kelly-kassin/PROJET_COMMUNICATION_CHIFFREE/Partie_ARCHITECTURE/Capture d'écran 2026-10-26 230341.png

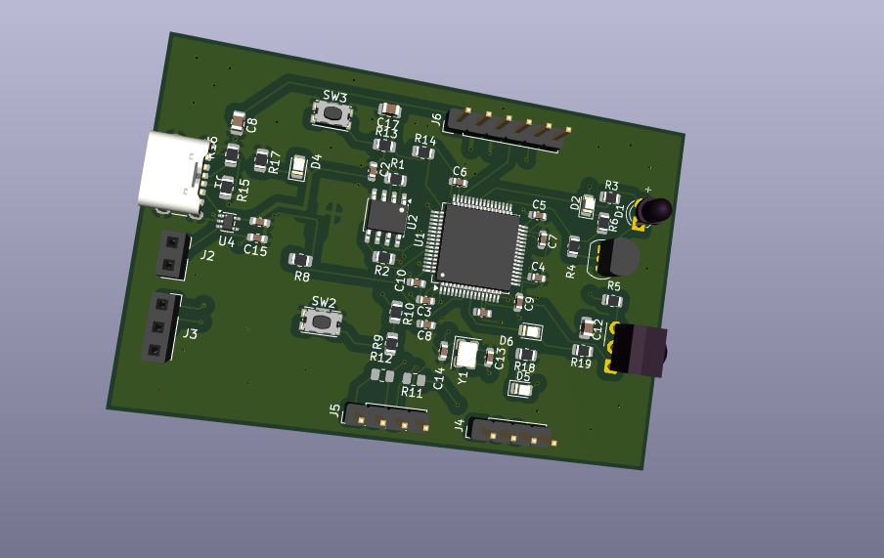
Partie_ARCHITECTURE/Capture d'écran 2026-10-26 230341.png
