kelly-kassin/PROJET_COMMUNICATION_CHIFFREE/README.md

# Projet_PCB_FISE_5A_POLYTECH : Communication IR Cryptée
# Binome : Kelly KASSIN & Youssef OMMI
