kelly-kassin/PROJET_COMMUNICATION_CHIFFREE/Partie Software/To_Do_List.odt

Partie Software :

1. Firmware : configuration de base du microcontrôleur STM32F413RGT6 : registre, mémoire,etc.
2. Code pour le protocole NEC
3. Communication I2C : programmer des fonctions ou classes faire la communication
4. Communication uart : programmer des fonctions ou classes faire la communication
