kelly-kassin/PROJET_COMMUNICATION_CHIFFREE/Partie_ARCHITECTURE/FAST.ods

FAST Diagram ( Functional Analysis System Technique ) Project : Communication cryptée Team Number : 0 Authors : Kelly KASSIN
About this document : It’s not mandatory to fully complete immediatly but is an excellent tool to start organize your project. It will help you to : - 1. describe a complete strucutre of your design functions and choices - 2. communicate them easily and close the gap between electrical, firmware, mechanical and other disciplines - 3. prepare the structure for other documents like : architecture, technical specifications, test plan, budget .. It’s applicable and ajustable for many kind of projects, not only embedded systems. This particular template will give you a generic exemple for an environmental sensor and the beginning of Power Architecture while providing exemples for technical solutions you’ll be able to explore.
Main Function | Service Function | Basic Function | Technical Solutions (final choice) | Technical Solutions (proposals) pick one or severals, add your ideas and findings | Related Technical Specification | Notes/Comment/Questions/Todo(Who)
1. Assurer une communication cryptée entre deux appareils par infrarouge (IR) | 1.1 Envoyer des commandes pour le controle d'un servomoteur | 1.1.1 Recevoir le message à crypter par l'utilisateur | - Moniteur serie uart vers pc | - Moniteur série - clavier matriciel 4×4 - interface USB | - L'utilisateur envoie les commandes à crypter depuis un PC au Master ( STM nucléo) qui va crypter l'information et l'envoyer
 |  | 1.1.1 Crypter le message | - TPM ST33TPHF2EI2C (optionnel pour le moment) | - TPM ST33TPHF2EI2C ( LQFP144 (20 x 20 mm)) - TPM ST33KTPM2XSPI ( UFQFPN32 5 × 5 × 0.55 mm) - TPM ST33KTPM2X (UFQFPN32 5 × 5 × 0.55 mm) | LQFP , not UFQFPN
 |  | 1.1.2 Contrôle et traitement de données ( + cryptage) | - STM32F413RGTx | - STM32 RAM (volatile) - STM32 Flash (non-volatile) - STM32 Backup-Registers (for battery) - External Memory (EEPROM, MRAM, …) | FW Functions & Architecture
 |  | 1.1.3 Envoie de l'information chiffrée (Signal IR) | - Protocole NEC - Transmetteur IR: TSAL6200 |  | - GPIO - Timer - PWM
 |  | 1.1.4 Reception de l'information | - Protocole NEC - Recepteur IR: TSOP38438 |  | - GPIO - Timer - Capteur d'entrée
 |  | 1.1.5 Decodage du message | - TPM ST33TPHF2EI2C
 |  | 1.1.6 Affichage du message | - Ecran I2C Oled | - Ecran LCD - Ecran Oled
2. Programmer, debugger, tester et interagir avec la carte | 2.1 Programmer et déboguer le composant | 2.1.1 Accéder au port SWD | - Connecteur SWD (CLK/DATA, NRST, 3V3, GND)
 | 2.2 Communiquer avec le PC | 2.2.1 Accéder à la console UART PC | - Port UART PC : USART2 (TX/RX) vers câble FTDI 3,3 V
 | 2.3 Interagir avec la carte | 2.3.1 Bouton poussoir pour des tests | - USER_BUTTON sur une GPIO (EXTI)
 |  | 2.3.2 Réinitialiser le MCU | - RST_BUTTON
 |  | 2.3.3 Voir l'influence du bouton USER | - LED1 sur une GPIO
 | 2.4 Faire fonctionner le microcontrôleur | 2.4.1 Générer l'horloge | - Quartz 8 MHz
 |  | 2.4.2 Choisir le mode de démarrage | - Broche BOOT0 : résistance vers GND (+ cavalier optionnel)
 |  | 2.4.3 Découpler l'alimentation du MCU | - 100 nF par broche VDD, VDDA filtrée, VBAT, VCAP1/VCAP2 (2,2 µF)
 | 2.5 Rendre la carte testable | 2.5.1 Prévoir des points de test | - Pastilles de test : 3V3, GND, SCL, SDA, TX, RX, sortie IR, entrée IR
3. Alimentation du système | 3.1 Acquire a power source for all component | 3.1.1 Connecter le MCU à la source d'alimentation | - USB 5V | - Pin Header + Lab Power Supply - USB 5V - Batterie (ex : Supercapacitor) | - Voltage - Maximum Current/Power - Power Protection
 |  | 3.1.2 Régler la tension d'entrée du rail d'alimentation 3V3 | - DC Converter | DC Converter (Linear) : - Low Dropout Regulator (LDO) DC Converter (Switching Mode) : - Buck Regulator - Boost Regulator | - Maximum Current - Power budget analysis - Efficiency - Thermal Power Dissipation (especially for LDOs)
 |  | 3.1.3 Informer que la carte est alimentée | LED Diode |  | - LED Color / Position on the board - LED Current - Current Resistor Selection (LED Current + Power Rating)
 |  | 3.1.4 Alimenter la carte | 3V3 |  | -STM32 Current Consumption -Power Decoupling | Use STM32CubeMX software to estimate the consumption or the STM32 of your choice’s datasheet
 |  | 3.1.5 Alimenter le TPM | 3V3 sur VPS |  | - filtrage (ferrite + condensateurs)
 |  | 3.1.6 Alimenter les capteurs IR | 3V3 |  | TSOP38438 via RC
 |  | 3.1.7 Alimenter les diodes
