kelly-kassin/PROJET_COMMUNICATION_CHIFFREE/Documents/02-Architecture-Diagrammes/Template_FAST.ods

FAST Diagram ( Functional Analysis System Technique ) Project : Generic Sensor with STM32 Exemple/Template Team Number : 0 Authors :
About this document : It’s not mandatory to fully complete immediatly but is an excellent tool to start organize your project. It will help you to : - 1. describe a complete strucutre of your design functions and choices - 2. communicate them easily and close the gap between electrical, firmware, mechanical and other disciplines - 3. prepare the structure for other documents like : architecture, technical specifications, test plan, budget .. It’s applicable and ajustable for many kind of projects, not only embedded systems. This particular template will give you a generic exemple for an environmental sensor and the beginning of Power Architecture while providing exemples for technical solutions you’ll be able to explore.
Main Function | Service Function | Basic Function | Technical Solutions (final choice) | Technical Solutions (proposals) pick one or severals, add your ideas and findings | Related Technical Specification | Notes/Comment/Questions/Todo(Who)
1. Main function 1 | 1.1 Acquire an environmental parameter | 1.1.1 Measure the environmental parameter | Sensor | / | - Environmental Parameter & Contraints ( ex: lumineous intensity, acceleration, temperature precision, laser distance, your beautiful voice, , joystick position …)
 |  | 1.1.1 Acquire the data | TBD (To Be Defined) | Digital Communication : -I2C -SPI -Digital Pin Analog Measurement : - STM32 ADC - Comparator/Filter circuit | Ex : Data Size, Frequency, I2C Address, Analog Range/Filtering)
 |  | 1.1.2 Control & Process data | STM32 | Alarms, Counting, FFT | FW Functions & Architecture
 |  | 1.1.3 Store the data | / | - STM32 RAM (volatile) - STM32 Flash (non-volatile) - STM32 Backup-Registers (for battery) - External Memory (EEPROM, MRAM, …) | Ex : Data size/format, communication protocol
 |  | 1.1.4 Display the data | / | -LCD/OLED Screen -LED | Ex : Screen size, colors, data fomat
 |  | 1.1.5 Communicate the data | / | -UART Console -Infrared Communcation -Wireless Communication | Ex : Speed, Range, Error Correction
 |  | 1.X.X
X. Power-up the system | X.1 Acquire a power source for all component | X.1.1 Connect to the power source | TBD | - Pin Header + Lab Power Supply - USB 5V - Battery (ex : Supercapacitor) | - Voltage - Maximum Current/Power - Power Protection
 |  | X.1.2 Regulate the input voltage for the 3V3 power-rail | TBD | DC Converter (Linear) : - Low Dropout Regulator (LDO) DC Converter (Switching Mode) : - Buck Regulator - Boost Regulator | - Maximum Current - Power budget analysis - Efficiency - Thermal Power Dissipation (especially for LDOs)
 |  | X.1.3 Inform the user about 3V3 voltage presence | LED Diode |  | - LED Color / Position on the board - LED Current - Current Resistor Selection (LED Current + Power Rating)
 |  | X.1.4 Provide power to the STM32 | 3V3 |  | -STM32 Current Consumption -Power Decoupling | Use STM32CubeMX software to estimate the consumption or the STM32 of your choice’s datasheet
 |  |  | VBAT | VBAT Power Rail (if you use a battery) | - Autonomy
 |  | X.1.X Provide power to the sensor/display/battery ….
