kelly-kassin/PROJET_COMMUNICATION_CHIFFREE/Références.odt

1. Schéma de l’oscillateur : page 110 du document C468260.pdf

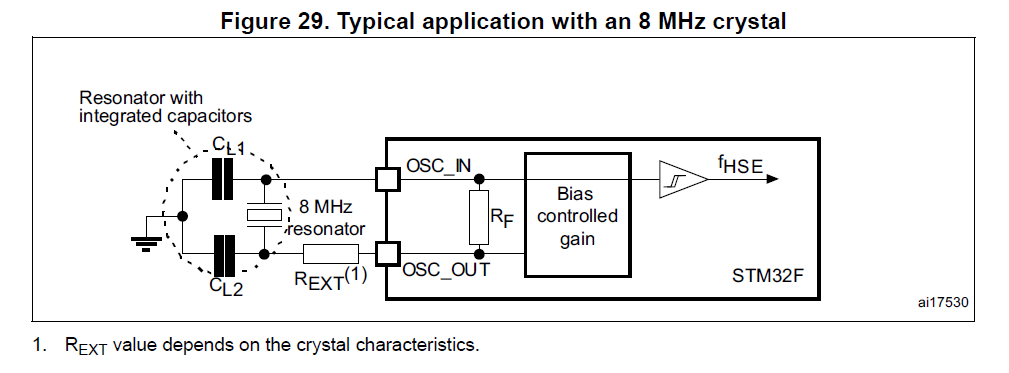
[picture p3: figure]
