kelly-kassin/PROJET_COMMUNICATION_CHIFFREE/Partie_ARCHITECTURE/Informations pour le choix du convertisseur_DC_DC.png

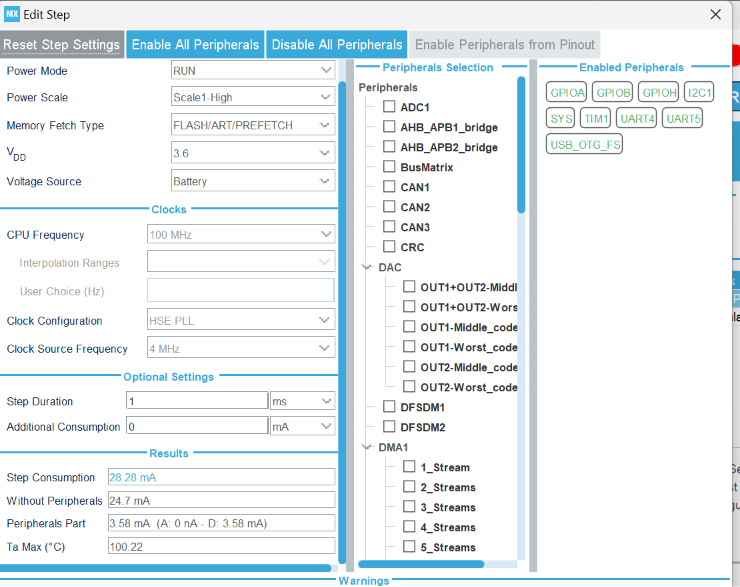
Partie_ARCHITECTURE/Informations pour le choix du convertisseur_DC_DC.png
