kelly-kassin/PROJET_COMMUNICATION_CHIFFREE/Partie_ARCHITECTURE/pcb_connexion2.png

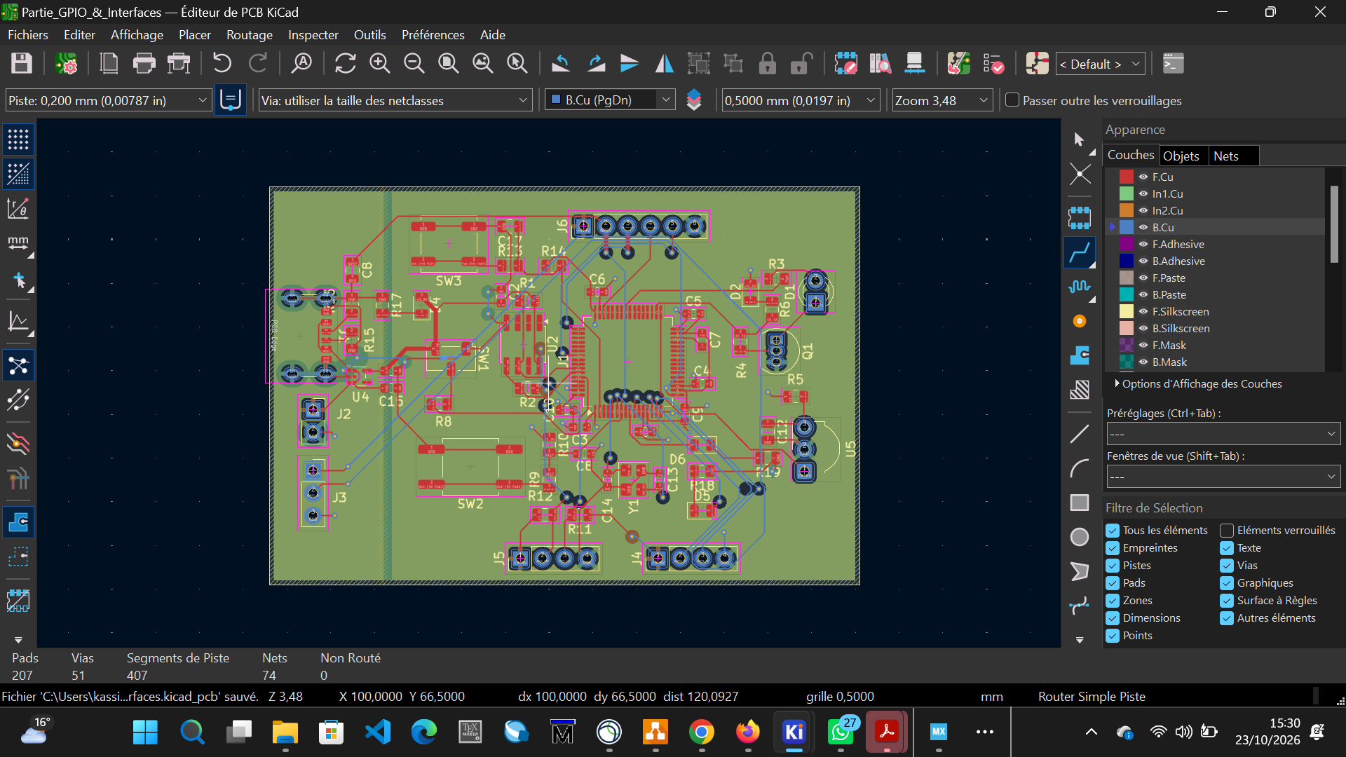
Partie_ARCHITECTURE/pcb_connexion2.png
