kelly-kassin/PROJET_COMMUNICATION_CHIFFREE/Partie_ARCHITECTURE/pcb_connexion.png

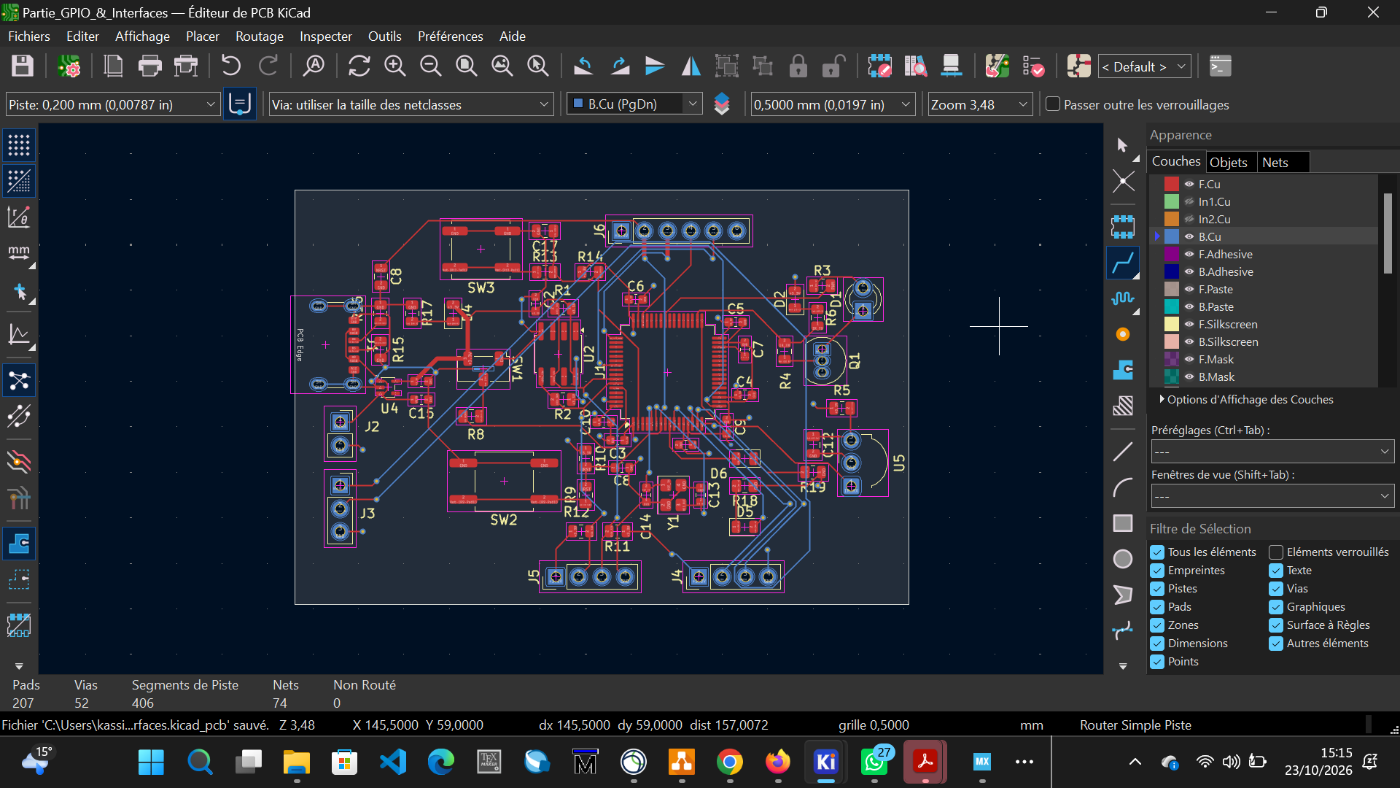
Partie_ARCHITECTURE/pcb_connexion.png
