kelly-kassin/PROJET_COMMUNICATION_CHIFFREE/Partie_ARCHITECTURE/Premier_pcb_sur_jlcpcb.png

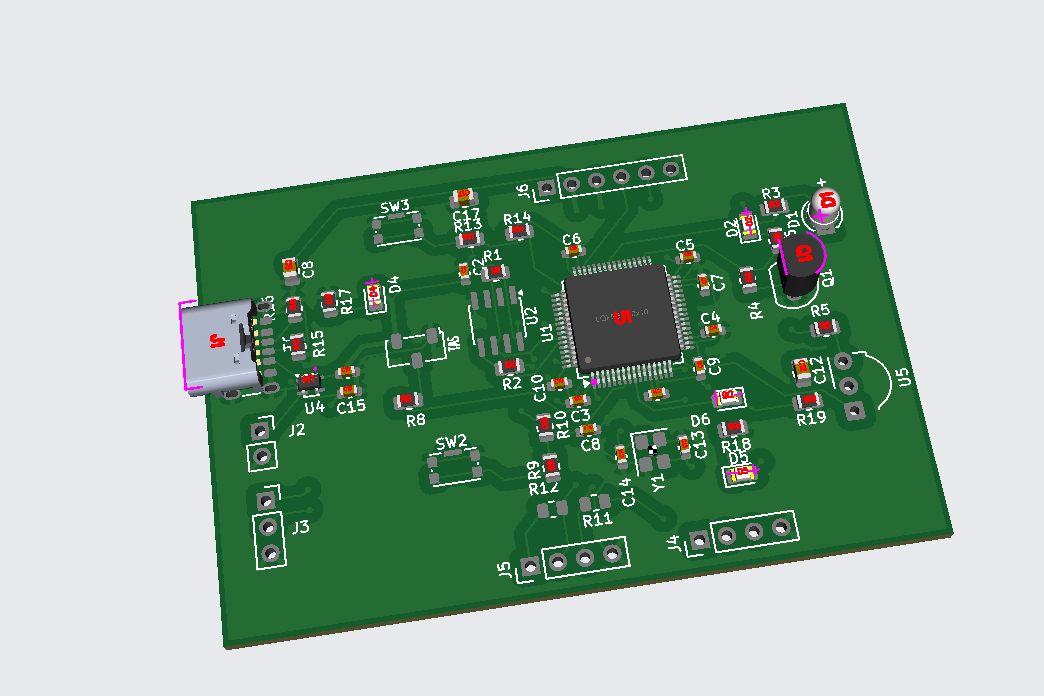
Partie_ARCHITECTURE/Premier_pcb_sur_jlcpcb.png
