kelly-kassin/PROJET_COMMUNICATION_CHIFFREE/Projet_KICAD/production/bom.csv

Designator | Footprint | Quantity | Value | LCSC Part #
C10, C11, C2, C4, C5, C6, C8_2 | 0603 | 7 | 100nF
C12, C17, C8 | 0805 | 3 | 100nF
C13, C14 | 0603 | 2 | 20nF
C15, C16 | 0603 | 2 | 1uF
C3 | 0603 | 1 | 4.7 uF
C7 | 0603 | 1 | 4.7uF
C9 | 0603 | 1 | 2.2uF
D1 | LED_D3.0mm_IRBlack | 1 | TSAL4400
D2 | 0805 | 1 | LED GREEN | C2297
D4 | 0805 | 1 | LED RED
D5 | 0805 | 1 | LED YELLOW
D6 | 0805 | 1 | LED BLUE
J1 | USB_C_Receptacle_GCT_USB4125-xx-x-0190_6P_TopMnt_Horizontal | 1 | USB4125-GF-A-0190
J2 | PinSocket_1x02_P2.54mm_Vertical | 1 | Conn_01x02_Pin | C49661
J3 | PinSocket_1x03_P2.54mm_Vertical | 1 | Conn_01x03_Pin | C22373889
J4, J5 | PinHeader_1x04_P2.54mm_Vertical | 2 | Conn_01x04_Pin | C32713270
J6 | PinHeader_1x06_P2.54mm_Vertical | 1 | Conn_01x06_Pin | C32713272
Q1 | TO-92_Inline | 1 | 2N3906
R1, R2 | 0805 | 2 | 4.7k | C17673
R10, R14, R8 | 0805 | 3 | 10k | C17414
R11, R12 | 0805 | 2 | 4.7k
R13, R17, R18, R19, R3, R4, R6, R9 | 0805 | 8 | 330 | C17630
R15 | 0805 | 1 | 5.1K | C26023
R16 | 0805 | 1 | 5.1k | C27834
R5 | 0805 | 1 | 100 | C17408
SW2, SW3 | SW_Push_1P1T-SH_NO_CK_KMR2xxG | 2 | SW_Push | C269272
U1 | LQFP-64_10x10mm_P0.5mm | 1 | STM32F413RGT6
U2 | SOIC-8_3.9x4.9mm_P1.27mm | 1 | ATECC608C | C25469796
U4 | SOT-353_SC-70-5 | 1 | MIC5365-3.3YC5 | C3021118
U5 | Vishay_MOLD-3Pin | 1 | TSOP34138 | C118303
Y1 | Crystal_SMD_3225-4Pin_3.2x2.5mm | 1 | Y322518.432MLBCX
