kelly-kassin/PROJET_COMMUNICATION_CHIFFREE/Projet_KICAD/Partie_GPIO_&_Interfaces.kicad_pcb

## KiCad design Projet_KICAD/Partie_GPIO_&_Interfaces.kicad_pcb (2026-11-06)

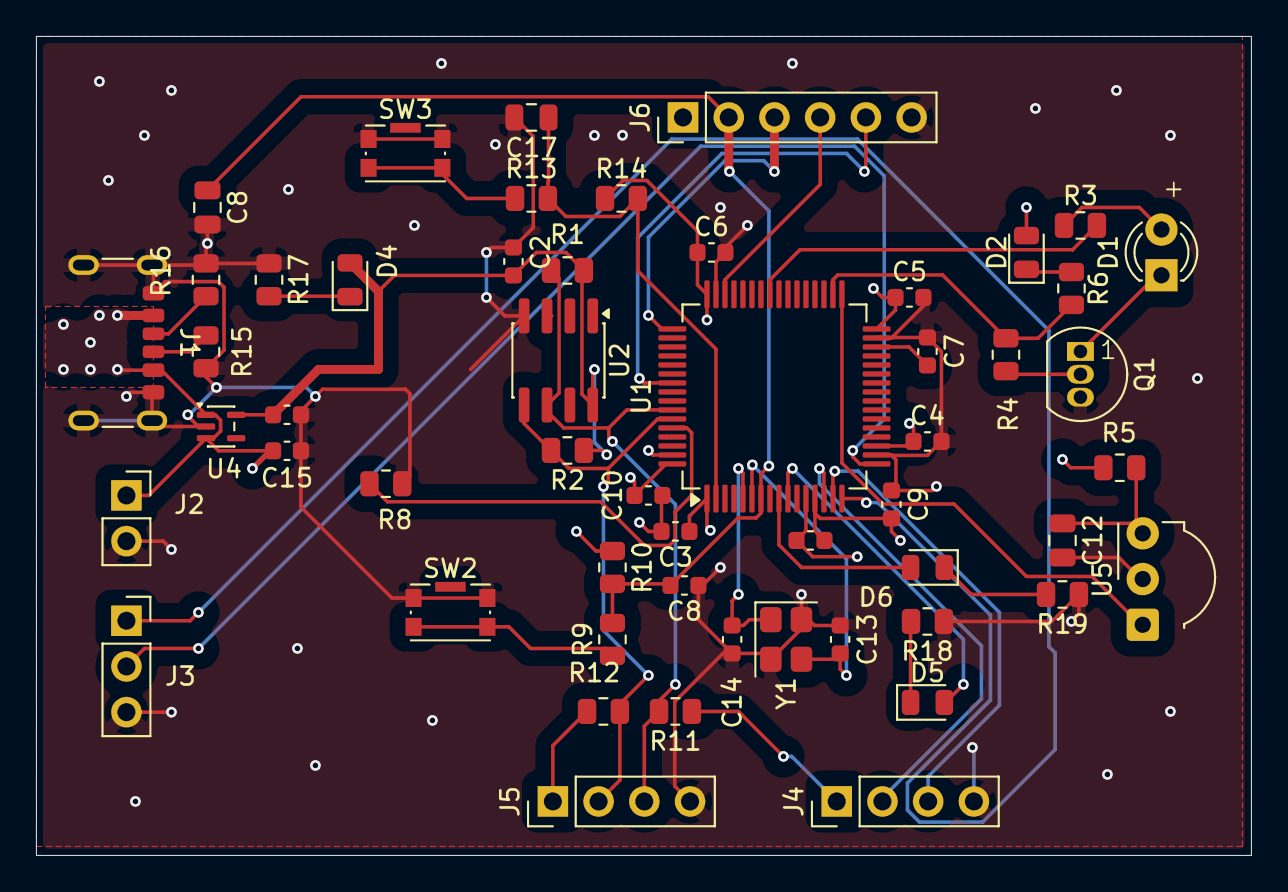
[picture p8: board Partie_GPIO_&_Interfaces.kicad_pcb from above]

Board: 4 copper layers, 67.5 x 45.5 mm, 54 parts (0 on the bottom side), 35 nets.

Parts:
C2, C4, C5, C6, C8, C10, C11: 100nF; C_0603_1608Metric
C3: 4.7 uF; C_0603_1608Metric
C7: 4.7uF; C_0603_1608Metric
C8#2, C12, C17: 100nF; C_0805_2012Metric
C9: 2.2uF; C_0603_1608Metric
C13, C14: 20nF; C_0603_1608Metric
C15, C16: 1uF; C_0603_1608Metric
D1: TSAL4400; LED_D3.0mm_IRBlack
D2: LED GREEN; LED_0805_2012Metric
D4: LED RED; LED_0805_2012Metric
D5: LED YELLOW; LED_0805_2012Metric
D6: LED BLUE; LED_0805_2012Metric
J1: USB4125-GF-A-0190; USB_C_Receptacle_GCT_USB4125-xx-x-0190_6P_TopMnt_Horizontal
J2: Conn_01x02_Pin; PinSocket_1x02_P2.54mm_Vertical
J3: Conn_01x03_Pin; PinSocket_1x03_P2.54mm_Vertical
J4, J5: Conn_01x04_Pin; PinHeader_1x04_P2.54mm_Vertical
J6: Conn_01x06_Pin; PinHeader_1x06_P2.54mm_Vertical
Q1: 2N3906; TO-92_Inline
R1, R2, R11, R12: 4.7k; R_0805_2012Metric
R3, R4, R6, R9, R13, R17, R18, R19: 330; R_0805_2012Metric
R5: 100; R_0805_2012Metric
R8, R10, R14: 10k; R_0805_2012Metric
R15: 5.1K; R_0805_2012Metric
R16: 5.1k; R_0805_2012Metric
SW2, SW3: SW_Push; SW_Push_1P1T-SH_NO_CK_KMR2xxG
U1: STM32F413RGT6; LQFP-64_10x10mm_P0.5mm
U2: ATECC608C; SOIC-8_3.9x4.9mm_P1.27mm
U4: MIC5365-3.3YC5; SOT-353_SC-70-5
U5: TSOP34138; Vishay_MOLD-3Pin
Y1: Y322518.432MLBCX; Crystal_SMD_3225-4Pin_3.2x2.5mm

Connections:
+3.3V: C2.1, C3.1, C4.1, C5.1, C6.1, C9.1, C10.1, C11.1, C16.1, D2.2 (A), D4.2 (A), J4.1, J5.1, J6.1, R1.1, R2.1, R5.1, R10.1, R11.1, R12.1, R14.1, U1.1 (VBAT), U1.13 (VDDA), U1.19 (VDD), U1.32 (VDD), U1.48 (VDD), U1.64 (VDD), U2.8 (VCC), U4.5 (VOUT)
/GPIO_EXTI13: C17.1, R13.2, R14.2, U1.2 (PC13)
/HSE_IN: C14.2, U1.5 (PH0), Y1.1
/HSE_OUT: C13.2, U1.6 (PH1), Y1.3
/I2C1_SCL: J5.3, R1.2, R11.2, U1.58 (PB6), U2.6 (SCL)
/I2C1_SDA: J5.2, R2.2, R12.2, U1.59 (PB7), U2.5 (SDA)
/IR_RX: U1.33 (PB12), U5.1 (OUT)
/IR_TX: R4.2, R6.1, U1.34 (PB13)
/LED_IR_RX: D6.2 (A), U1.9 (PC1)
/NRST: C8.2, C8#2.1, J6.2, R9.2, R10.2, U1.7 (NRST)
/PWM: R3.2, U1.41 (PA8)
/SW_BOOT0: R8.1, U1.60 (BOOT0)
/SYS_JTDCK_SWDCLK: J6.3, U1.49 (PA14)
/SYS_JTDMS-SWDIO: J6.4, U1.46 (PA13)
/SYS_JTDO_SWDO: J6.5, U1.55 (PB3)
/UART2_RX: J3.2, U1.17 (PA3)
/UART2_TX: J3.1, U1.16 (PA2)
/UART4_RX: J4.3, U1.15 (PA1)
/UART4_TX: J4.2, U1.14 (PA0)
/VUSB: C15.1, J1.A9 (VBUS), J1.B9 (VBUS), J2.1, U4.1 (VIN), U4.3 (EN)
GND: C2.2, C3.2, C4.2, C5.2, C6.2, C7.2, C8.1, C8#2.2, C9.2, C10.2, C11.2, C12.2, C13.1, C14.1, C15.2, C16.2, C17.2, J1.A12 (GND), J1.B12 (GND), J1.SH (SHIELD), J2.2, J3.3, J4.4, J5.4, J6.6, Q1.3 (C), R8.2, R15.1, R16.1, R17.1, R18.1, R19.1, SW2.1, SW3.1, U1.12 (VSSA), U1.18 (VSS), U1.31 (VSS), U1.47 (VSS), U1.63 (VSS), U2.4 (GND), U4.2 (GND), U5.2 (GND), Y1.2 (G), Y1.4 (G)
unnamed: D1.2 (A), R3.1
unnamed: D1.1 (K), Q1.1 (E)
unnamed: D2.1 (K), R6.2
unnamed: D4.1 (K), R17.2
unnamed: D5.2 (A), U1.10 (PC2)
unnamed: D5.1 (K), R18.2
unnamed: D6.1 (K), R19.2
unnamed: J1.A5 (CC1), R16.2
unnamed: J1.B5 (CC2), R15.2
unnamed: Q1.2 (B), R4.1
unnamed: R9.1, SW2.2
unnamed: R13.1, SW3.2
unnamed: C7.1, U1.30 (VCAP_1)
unnamed: C12.1, R5.2, U5.3 (Vs)
