kelly-kassin/PROJET_COMMUNICATION_CHIFFREE/Partie Software/STMCubeMX.ioc

Mcu.UserName=STM32F413RGTx
PA0.Signal=UART4_TX
PA1.Signal=UART4_RX
PA13.Signal=SYS_JTMS-SWDIO
PA14.Signal=SYS_JTCK-SWCLK
PA2.Signal=USART2_TX
PA3.Signal=USART2_RX
PA8.Signal=S_TIM1_CH1
PB12.Signal=UART5_RX
PB13.Signal=UART5_TX
PB3.Signal=SYS_JTDO-SWO
PB6.Signal=I2C1_SCL
PB7.Signal=I2C1_SDA
PC1.Signal=GPIO_Output
PC13.Signal=GPXTI13
PC2.GPIO_Label=LED_USER
PC2.Signal=GPIO_Output
